garrett-tjernagel/A.R.M_UNDCEMEE481SeniorDesignProject/README.md

# A.R.M_UNDCEMEE481SeniorDesignProject
This is the A.R.M Project repo for my groups senior design project at UND. 

included are the libraries that were used to make the project work
