garrett-tjernagel/A.R.M_UNDCEMEE481SeniorDesignProject/Mirror Movement Robotic Arm Garrett Tjernagel Branson Elliott and Will Prody.pdf

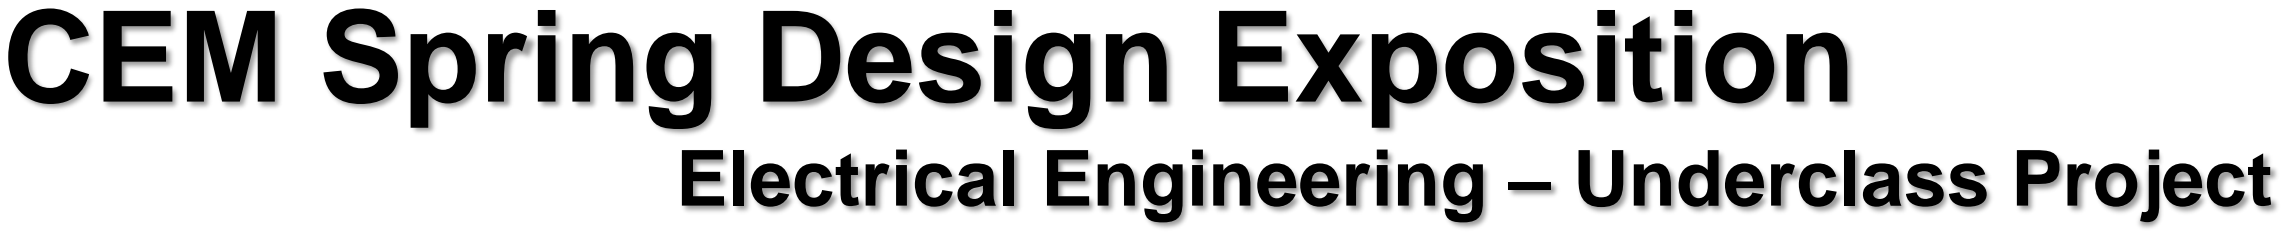
[picture p14: figure]
CEM Spring Design Exposition

Electrical Engineering – Underclass Project

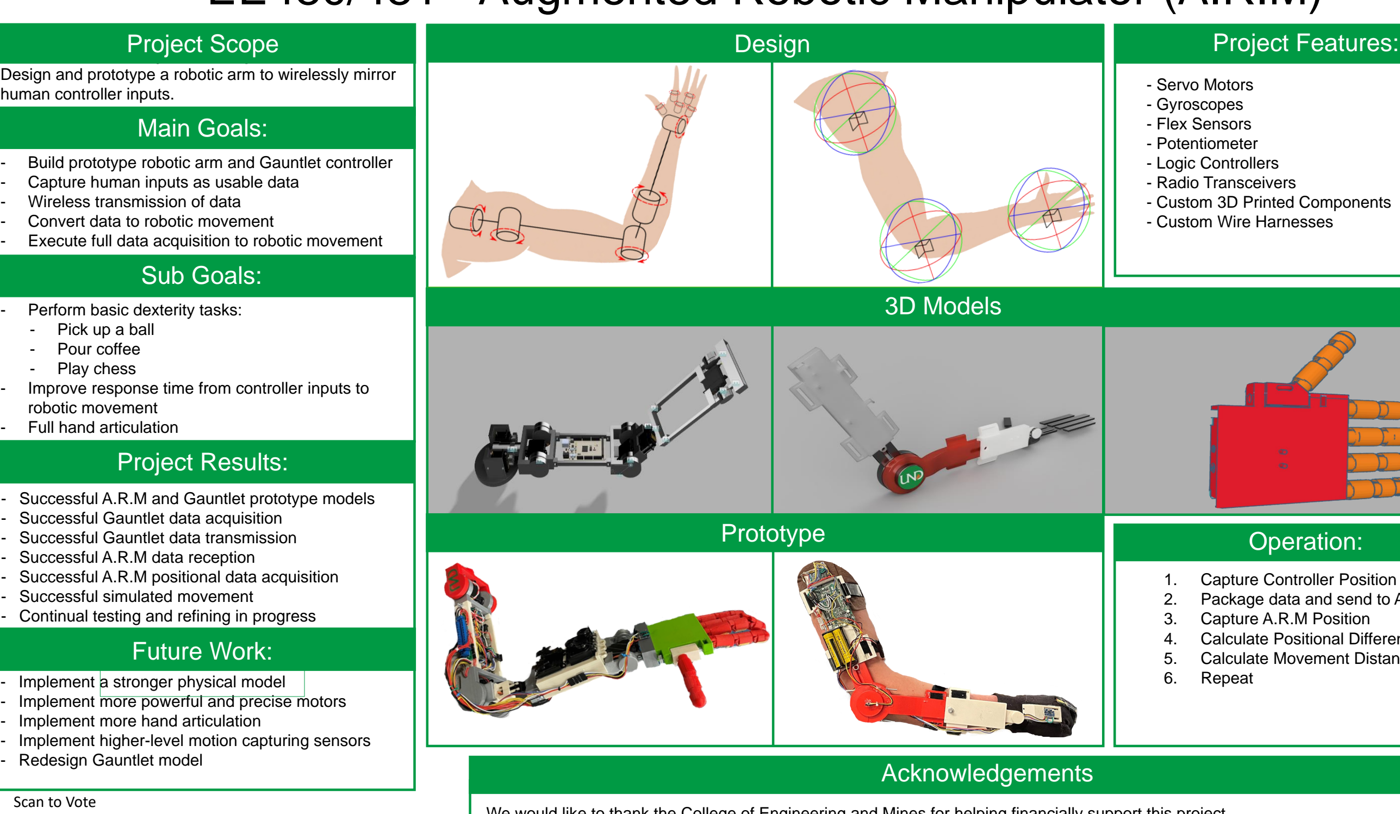
[picture p15: figure]
Design; 3D Models; Prototype; Project Scope; Project Features:; Operation:; - Successful Gauntlet data acquisition - Successful Gauntlet data transmission - Successful A.R.M data reception; - Successful simulated movement; Acknowledgements

Scan to Vote

# EE480/481 - Augmented Robotic Manipulator (A.R.M)

Team: William Prody, Branson Elliott, and Garrett Tjernagel Advisor: Tarek Elderini

## Project Scope:

Design and prototype a robotic arm to wirelessly mirror human controller inputs.

## Main Goals:

- Build prototype robotic arm and Gauntlet controller
- Capture human inputs as usable data
- Wireless transmission of data
- Convert data to robotic movement
- Execute full data acquisition to robotic movement

## Sub Goals:

- Perform basic dexterity tasks:
- Pick up a ball
- Pour coffee
- Play chess
- Improve response time from controller inputs to robotic movement
- Full hand articulation
- Implement a stronger physical model
- Implement more powerful and precise motors
- Implement more hand articulation
- Implement higher-level motion capturing sensors
- Redesign Gauntlet model

Prototype Features:

- Servo Motors
- Gyroscopes
- Flex Sensors
- Potentiometer
- Logic Controllers
- Radio Transceivers
- Custom 3D Printed Components
- Custom Wire Harnesses

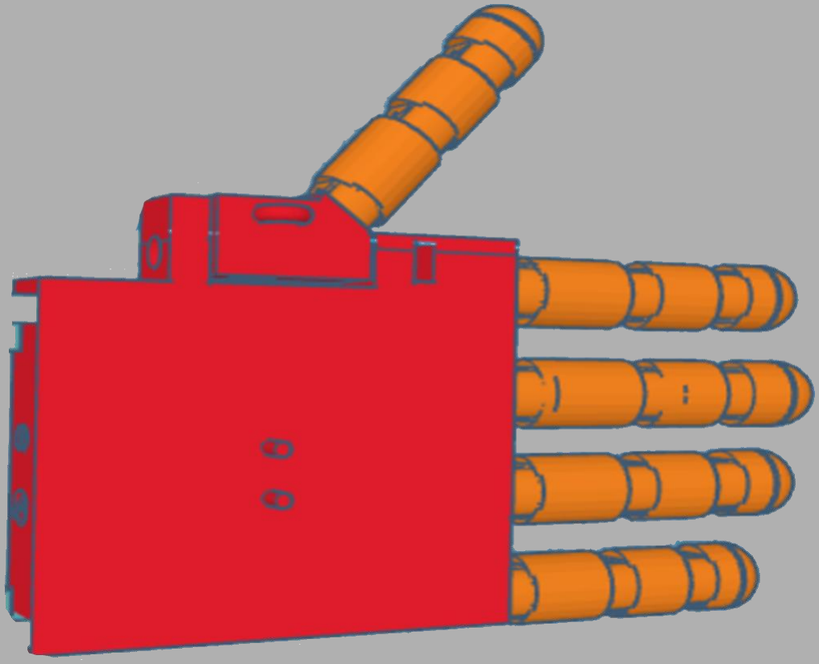
[picture p16: figure]

1. Capture Controller Position
2. Package data and send to A.R.M
3. Capture A.R.M Position
4. Calculate Positional Difference
5. Calculate Movement Distance
6. Repeat

## Project Results:

## Future Work:

## Sub Goals:

## Main Goals:

- Successful A.R.M and Gauntlet prototype models
- Successful A.R.M positional data acquisition
- Continual testing and refining in progress

We would like to thank the College of Engineering and Mines for helping financially support this project.
We would like to extend an extra thanks to Tarek Elderini for his continued guidance in our previous endeavors over the years. It has been a pleasure to learn from and work with him on this and previous projects.
