garrett-tjernagel/A.R.M_UNDCEMEE481SeniorDesignProject/(commit log)

2022-04-13 Redo of Gyro Readings
    Ran into issues with jeff rowbergs example sketch for compiling errors, found a new library to build off of from adafruit.
    [GauntletControllerv2.ino]
2022-04-13 Update GauntletControllerv2.ino
    can read time between samples. added a parameter for sampling time for movement
2022-04-13 Update GauntletControllerv2.ino
    Have Successful rotational velocity average over a configurable sampling time, and have an output current rotational angle from the implied 'zero' position.
    will now add a redundancy zero-ing after reset and on start up as well as y and z positional data.
    [GauntletControllerv2.ino]
2022-04-14 Update GauntletControllerv2.ino
    Reset gyro 1 to reset every cycle so that we only measure the change in angular acceleration each cycle and add the change in rotational position to the main.
    [GauntletControllerv2.ino]
2022-04-14 Pretty Consistent dual gyroscope positional data
    added functionality for the second gyroscope, data drifts much less now. Will implement a filter in the future.
    [GauntletControllerv2.ino]
2022-04-15 Quality of life fixes and fingers
    Added variables for the finger sensors, added code to measure the change in pressure from the pressure sensors for the fingers, moved code into different functions for each separate sensor parts.
    [GauntletControllerv2.ino]
2022-04-15 Added Intros, sources, radio, and organization
    Started the radio barebones stuff, will edit as needed for the correct array sizing as well as packaging.
    [GauntletControllerv2.ino]
2022-04-19 Bad note, but: Changes were made
    I dd this yesterday but im pretty sure i added the functionality to read the gyros on the arm and can start calibrating those then move onto recieveing and reading data from the gauntlet
2022-04-21 Added Arduino Libraries
2022-04-22 Changed Encoder to Potentiameter
    encoder didnt have the level of precision we wanted so changed it out for a potentiameter. Added pot map function to map the pot values read to the desired angle of rotation from 180-45. Next version will have hard limit variables for configuration.
2022-04-23 Added initial radio coms or ARM
2022-04-23 Organized and added radio start code for the arm and the gauntlet
2022-04-23 Organization and Added Servo Test
2022-04-23 Servo attach + servo test + organization
2022-04-23 Added Servo attachments + some servo limits
    one of the servo mounting horns wore down during testing, will need to attach a new mount, will begin radio testing in the mean time
2022-04-27 ARM Updates
    was able to get the arm to test the ranges of motion. Also added testing for ranges of motion for the fingers. However, the arm motors are not sized correctly, however controller can still be tested.
    [A.R.M_V1.ino]
2022-04-27 More organization
    added leds for status indicators instead of the planned 7 segment display
    organized the code structure
    removed the serial prints for some things
2022-04-27 more organization
    Serial not working for some reason
    [A.R.M_V1.ino, GauntletControllerv2.ino]
2022-04-27 Fixed Radio
    Removed LEDs since they were causing too much radio interferance
    [A.R.M_V1.ino, GauntletControllerv2.ino]
2022-04-28 We got the elbow to work with this
    started adding forearm functionality, commented out the elbow. Steps fo power arm, power serial monitor, power gauntlet.
2022-05-02 Continued testing for multiple servo control
2022-05-03 Adding Reference materials for future work
    Will update materials as neccesary
    [Averageing offsets.xlsx]
